031devstudios/weighmybru2/cad/step/WeighMyBru² - Touch Clamp.step

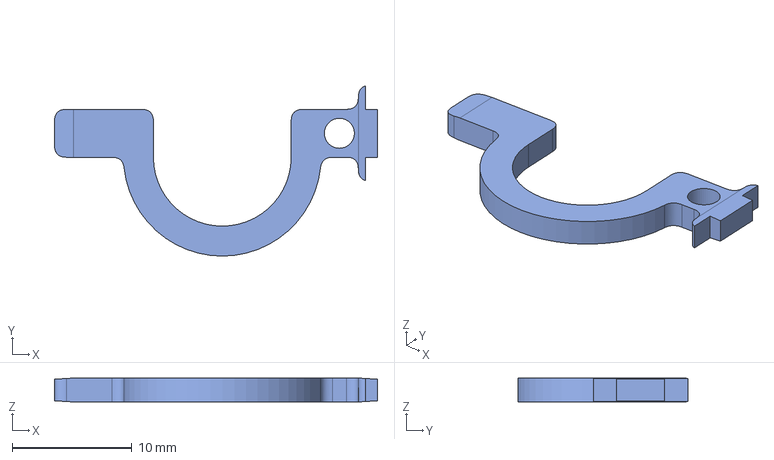
[picture p1: CAD file, 2025-12-10]
cad/step/WeighMyBru² - Touch Clamp.step
26.9 x 14.2 x 2.00 mm
