031devstudios/weighmybru2/cad/step/WeighMyBru² - Top (0.8mm).step

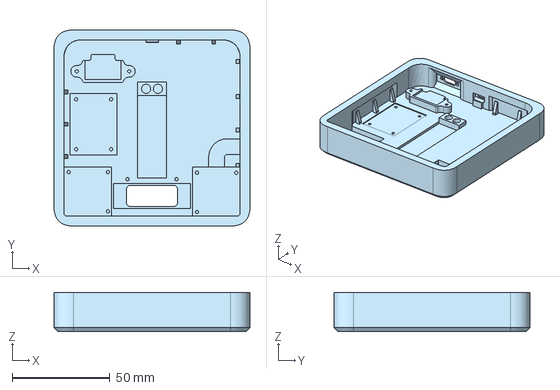
[picture p2: CAD file, 2025-12-10]
cad/step/WeighMyBru² - Top (0.8mm).step
100.0 x 100.0 x 20.0 mm
