031devstudios/weighmybru2/(list of files, cad)

Other CAD files:
cad/3mf/WeighMyBru² - Top (0.8mm).3mf
cad/3mf/WeighMyBru² - Touch Clamp.3mf
