031devstudios/weighmybru2/(commit log)

2025-11-18 🔖 Implement hybrid version management system
    - Add Version.h with manual version control and automatic build info
    - Integrate version information into serial output and web interface
    - Add comprehensive device info API endpoint (/api/device/info)
    - Include version data in dashboard API for frontend display
    - Support both ESP32-S3 Supermini and XIAO ESP32S3 board identification
    - Prepare foundation for ESP32 Web Tools integration
    Features:
    ✅ Manual semantic versioning (major.minor.patch)
    ✅ Automatic build numbers and commit hashes
    ✅ Board-specific identification
    ✅ Web API integration for version checking
    ✅ Detailed device information endpoint
2025-11-18 🚀 Add ESP32 Web Tools integration and automated build pipeline
    ✅ GitHub Actions workflows for release and development builds
    ✅ Automated ESP32 Web Tools manifest generation
    ✅ Cross-platform build scripts (bash + batch)
    ✅ Complete release automation with version tagging
    ✅ Web-based installation support
    Build System:
    - `build-release.yml` - Automated releases on git tags
    - `build-dev.yml` - Development build testing
    - `build.sh` / `build.bat` - Local build scripts
    - ESP32 Web Tools manifests for both boards
    - Comprehensive build information generation
    Installation Options:
    - 🌐 Web-based: ESP32 Web Tools via weighmybru.com
    - 💻 Developer: PlatformIO for advanced us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
2025-11-18 Add ESP32 Web Tools integration
    - Created Astro components for web-based firmware flashing
    - Added themed components matching WeighMyBru² design
    - Includes FlashFirmware, Navigation, and supporting components
    - Ready for deployment to weighmybru-site
2025-11-18 Add ESP32 Web Tools static website files
    - HTML template for firmware flashing
    - CSS styling matching WeighMyBru² theme
    - JavaScript integration with ESP32 Web Tools
    - Fallback option for non-Astro deployments
2025-11-18 feat: Add complete GitHub release v2.1.0 with ESP32 Web Tools
    - Complete 4-part flash package: bootloader, partitions, firmware, filesystem
    - LittleFS filesystem images (896KB) with full web interface
    - ESP32 Web Tools manifest files for both board variants
    - Updated release notes with filesystem and ESP32 Web Tools details
    - Comprehensive ESP32_WEB_TOOLS.md documentation
    Release includes:
    - weighmybru2-v2.1.0-esp32s3-supermini.bin (1.1MB)
    - weighmybru2-v2.1.0-xiao-esp32s3.bin (1.1MB)
    - littlefs-supermini.bin (896KB web interface)
    - littlefs-xiao.bin (896KB web interface)
    - manifest-*.json for ESP32 Web Tools integration
    - Complete documentation and installation guide
2025-12-09 Update BOM with AliExpress options
2025-12-10 chore: Remove astro-components and ESP32_WEB_TOOLS.md
    - astro-components directory no longer needed (integrated into website)
    - ESP32_WEB_TOOLS.md documentation moved to website/repository
    - Cleanup after successful website integration
2025-12-10 feat: Add CAD files for 3D printing and manufacturing
    - Added 3MF files for direct 3D printing:
    - WeighMyBru² - Top (0.8mm).3mf
    - WeighMyBru² - Touch Clamp.3mf
    - Added STEP files for CAD editing and manufacturing:
    - WeighMyBru² - Top (0.8mm).step
    - WeighMyBru² - Touch Clamp.step
    Provides complete mechanical design files for builders and manufacturers.
    [WeighMyBru² - Top (0.8mm).3mf, WeighMyBru² - Top (0.8mm).step, WeighMyBru² - Touch Clamp.3mf, WeighMyBru² - Touch Clamp.step]
2025-12-18 feat: Implement comprehensive power optimization reducing consumption to 0.05A
    - Reduce CPU frequency from 240MHz to 80MHz (66% power reduction)
    - Optimize update intervals: weight 20ms→50ms, BLE 50ms→100ms, display 100ms
    - Implement dual WiFi state persistence (NVS + EEPROM backup)
    - Fix WiFi power management with proper initialization/shutdown sequence
    - Add forced WiFi setup function to replicate tare button behavior
    - Ensure consistent 0.05A power consumption when WiFi disabled
    - Maintain BLE functionality when WiFi disabled for coffee app connectivity
    Power consumption results:
    - WiFi enabled: ~90mA (optimized from 100mA)
    - WiFi disabled: 0.05A (consistent after power cycling)
    - Ba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
    [WiFiManager.cpp, WiFiManager.h, main.cpp]
2025-12-18 feat: Add WiFi AP mode power optimization
    - Implement applyAPModePowerOptimization() function for battery efficiency
    - Reduce AP mode TX power from 19.5dBm to 15dBm for local connections
    - Increase beacon interval from 100ms to 200ms (50% reduction)
    - Limit max clients from 4 to 2 for reduced overhead
    - Enable ESP-IDF WIFI_PS_MIN_MODEM power save mode
    - Add mode-aware power management in applySuperMiniAntennaFix()
    - Expected power reduction: 20-30mA in AP mode (90mA → 70mA)
    - Maintains full functionality while optimizing battery life
2025-12-18 feat: Add WiFi network scanner and UI improvements
    - Implement WiFi network scanning with /api/wifi-scan endpoint
    - Add scanWiFiNetworks() function with JSON response including RSSI, encryption, channel
    - Create interactive network selection UI with signal strength indicators
    - Add color-coded signal bars (green/orange/red) with progressive fill levels
    - Implement clickable network list with hover effects and pointer cursor
    - Enhance WiFi form feedback with simplified reboot message
    - Improve user experience with one-click network selection
    - Sort networks by signal strength for better usability
    [WebServer.cpp, WiFiManager.cpp, WiFiManager.h]
2026-06-08 feat: Add auto-sleep timer with drift threshold setting
    [PowerManager.cpp, PowerManager.h, WebServer.cpp, WebServer.h, main.cpp]
